HakanBastedt/HobbyKingvarmare/Hobbykingvärmare-schematics.pdf

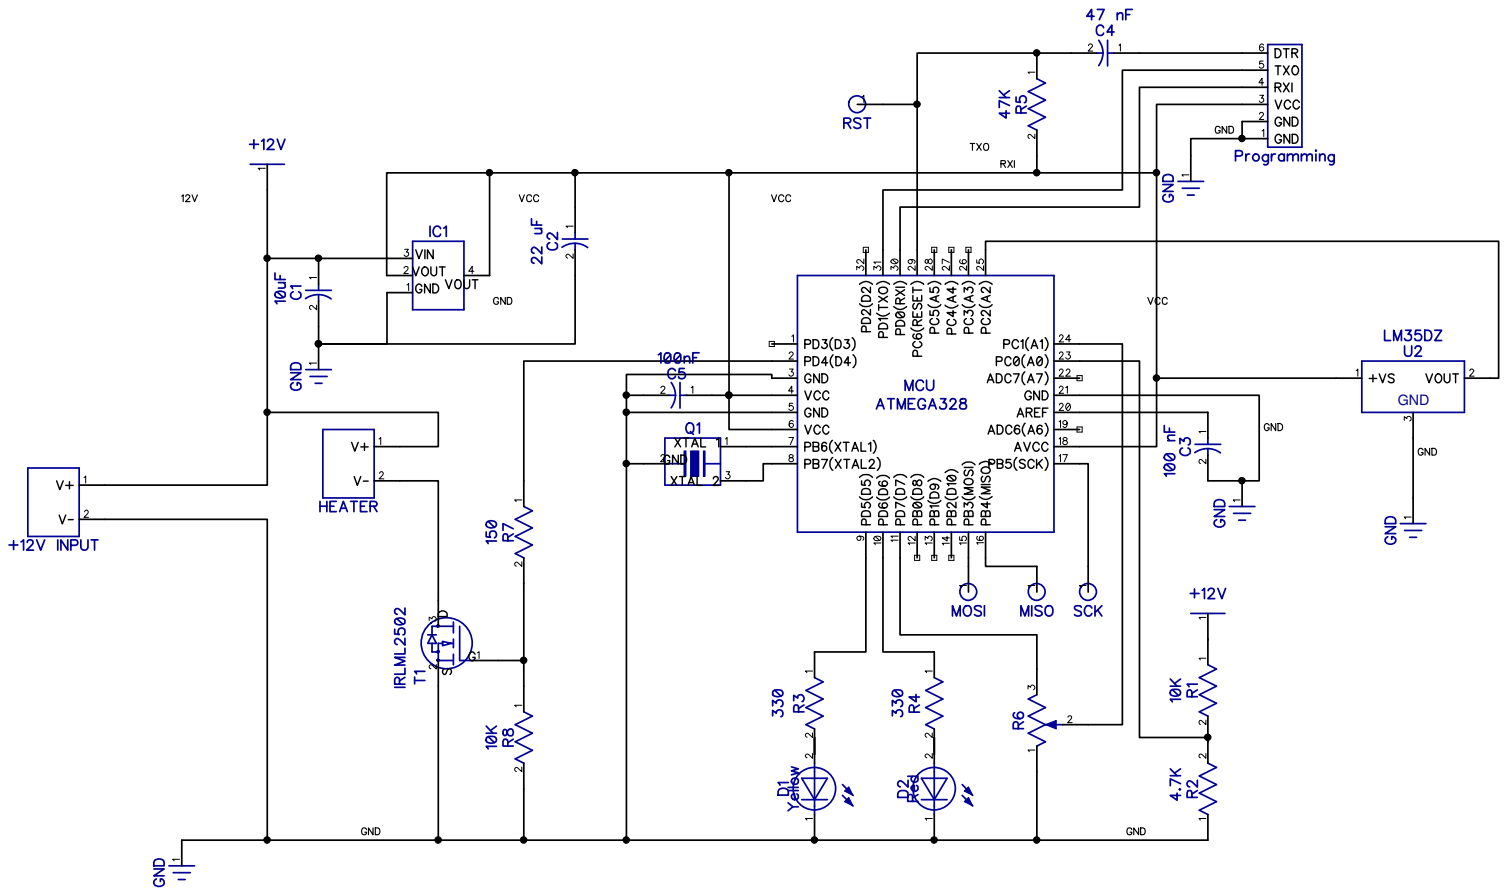
[picture p1: page 1]
GND
