HakanBastedt/HobbyKingvarmare/(commit log)

2015-11-30 Added schematics
2015-12-13 Fixed low-voltage shutdown of heater. Added Gerber and bom files
    [BOM.csv]
2015-12-13 Fixed low-voltage shutdown of heater.
    [HobbyKingvarmare.ino]
2015-12-18 Low Power mode. Ska dra i medel ca 10 mA med AMS1117 inklusive led blink Med mic5205 under 1 mA
2015-12-18 Added programming of lowest acceptable voltage before powering off
2015-12-29 Optimering för stabilitet + tweaking av PID parametrar
